Kyuhyeon34/FPGA_I2C_Sensor_Monitor/slave/constr/Basys3_slave.xdc

## Basys3 I2C SLAVE board

## Clock 100MHz
set_property -dict {PACKAGE_PIN W5 IOSTANDARD LVCMOS33} [get_ports clk]
create_clock -add -name sys_clk_pin -period 10.00 -waveform {0 5} [get_ports clk]

## Buttons
set_property -dict {PACKAGE_PIN U18 IOSTANDARD LVCMOS33} [get_ports reset]
set_property -dict {PACKAGE_PIN T18 IOSTANDARD LVCMOS33} [get_ports btn_mode]

## I2C : JA1 = SDA, JA2 = SCL  (connect JA5 GND <-> GND between boards)
set_property -dict {PACKAGE_PIN J1 IOSTANDARD LVCMOS33} [get_ports sda]
set_property -dict {PACKAGE_PIN L2 IOSTANDARD LVCMOS33} [get_ports scl]
## weak internal pull-up (backup). External 4.7k to 3.3V is recommended.
set_property PULLUP true [get_ports sda]
set_property PULLUP true [get_ports scl]

## Sensors on JB  (JA1 is used by SDA -> DHT11 moved from J1 to JB1)
set_property -dict {PACKAGE_PIN A14 IOSTANDARD LVCMOS33} [get_ports dht11_data]
set_property PULLUP true [get_ports dht11_data]
set_property -dict {PACKAGE_PIN A16 IOSTANDARD LVCMOS33} [get_ports trig]
set_property -dict {PACKAGE_PIN B15 IOSTANDARD LVCMOS33} [get_ports echo]

## UART
set_property -dict {PACKAGE_PIN A18 IOSTANDARD LVCMOS33} [get_ports RsTx]

## 7-segment  seg[0]=CA ... seg[6]=CG, seg[7]=DP
set_property -dict {PACKAGE_PIN W7 IOSTANDARD LVCMOS33} [get_ports {seg[0]}]
set_property -dict {PACKAGE_PIN W6 IOSTANDARD LVCMOS33} [get_ports {seg[1]}]
set_property -dict {PACKAGE_PIN U8 IOSTANDARD LVCMOS33} [get_ports {seg[2]}]
set_property -dict {PACKAGE_PIN V8 IOSTANDARD LVCMOS33} [get_ports {seg[3]}]
set_property -dict {PACKAGE_PIN U5 IOSTANDARD LVCMOS33} [get_ports {seg[4]}]
set_property -dict {PACKAGE_PIN V5 IOSTANDARD LVCMOS33} [get_ports {seg[5]}]
set_property -dict {PACKAGE_PIN U7 IOSTANDARD LVCMOS33} [get_ports {seg[6]}]
set_property -dict {PACKAGE_PIN V7 IOSTANDARD LVCMOS33} [get_ports {seg[7]}]

set_property -dict {PACKAGE_PIN U2 IOSTANDARD LVCMOS33} [get_ports {an[0]}]
set_property -dict {PACKAGE_PIN U4 IOSTANDARD LVCMOS33} [get_ports {an[1]}]
set_property -dict {PACKAGE_PIN V4 IOSTANDARD LVCMOS33} [get_ports {an[2]}]
set_property -dict {PACKAGE_PIN W4 IOSTANDARD LVCMOS33} [get_ports {an[3]}]

## LEDs
set_property -dict {PACKAGE_PIN U16 IOSTANDARD LVCMOS33} [get_ports {led[0]}]
set_property -dict {PACKAGE_PIN E19 IOSTANDARD LVCMOS33} [get_ports {led[1]}]
set_property -dict {PACKAGE_PIN U19 IOSTANDARD LVCMOS33} [get_ports {led[2]}]
set_property -dict {PACKAGE_PIN V19 IOSTANDARD LVCMOS33} [get_ports {led[3]}]
set_property -dict {PACKAGE_PIN W18 IOSTANDARD LVCMOS33} [get_ports {led[4]}]
set_property -dict {PACKAGE_PIN U15 IOSTANDARD LVCMOS33} [get_ports {led[5]}]
set_property -dict {PACKAGE_PIN U14 IOSTANDARD LVCMOS33} [get_ports {led[6]}]
set_property -dict {PACKAGE_PIN V14 IOSTANDARD LVCMOS33} [get_ports {led[7]}]
set_property -dict {PACKAGE_PIN V13 IOSTANDARD LVCMOS33} [get_ports {led[8]}]
set_property -dict {PACKAGE_PIN V3  IOSTANDARD LVCMOS33} [get_ports {led[9]}]
set_property -dict {PACKAGE_PIN W3  IOSTANDARD LVCMOS33} [get_ports {led[10]}]
set_property -dict {PACKAGE_PIN U3  IOSTANDARD LVCMOS33} [get_ports {led[11]}]
set_property -dict {PACKAGE_PIN P3  IOSTANDARD LVCMOS33} [get_ports {led[12]}]
set_property -dict {PACKAGE_PIN N3  IOSTANDARD LVCMOS33} [get_ports {led[13]}]
set_property -dict {PACKAGE_PIN P1  IOSTANDARD LVCMOS33} [get_ports {led[14]}]
set_property -dict {PACKAGE_PIN L1  IOSTANDARD LVCMOS33} [get_ports {led[15]}]

## Configuration
set_property CONFIG_VOLTAGE 3.3 [current_design]
set_property CFGBVS VCCO [current_design]
set_property BITSTREAM.GENERAL.COMPRESS TRUE [current_design]
set_property BITSTREAM.CONFIG.CONFIGRATE 33 [current_design]
set_property CONFIG_MODE SPIx4 [current_design]
