Kyuhyeon34/FPGA_I2C_Sensor_Monitor/(commit log)

2026-11-06 I2C 센서 모니터링 프로젝트 README · 폴더 구조
2026-11-06 I2C Slave 보드 소스 (src / sim / constr / tcl, 비트스트림, 리포트)
2026-11-06 feat(master): I2C Master 소스 및 시뮬레이션 환경 추가
2026-11-06 feat(master): update live sensor display and scope demos
    Use BTNU to toggle the FND between humidity/temperature and distance while
    keeping periodic sensor polling and independent validity checks.
    Render the received temperature fraction on the OLED and retain validated
    display snapshots through bus errors and screen updates.
    Add explicit all-sensor and individual scope simulation tops with the
    36 percent humidity, 28.4 C temperature and 3 cm distance demo, five-signal
    wave configuration, standalone waveform previews and execution guide.
    Include portable Vivado project/build scripts, the verified Master bitstream
    and current setup/hold, utilization and DRC reports.
    Validation: RTL/testbe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
    [tb_top.sv, tb_top_polling.sv, top.v]
2026-11-12 docs: 발표자료 PDF · 시연 영상 · 실물 사진 추가, README 정리
2026-11-12 docs: 시연 영상을 README 안에서 재생되도록 정리
2026-11-12 docs: README 맨 위 중복 영상 링크 제거
